noriakinakagawa/PowerPassController_LTC4417/README.md

# PowerPassController_LTC4417
LTC4417を使ったパワーパスコントローラ。安定化電源側のコネクタを抜くと瞬時にバッテリ側から電力が供給される。
バッテリ電圧が安定化電源より高くても安定化電源側を優先するので、理想ダイオードで冗長にしたものよりスマートに使える。
また、過電圧保護と低電圧保護も設定できるので、供給カットによりリチウム系バッテリの過放電を保護する。
部品は秋葉原で手に入る範囲に絞った。
