noriakinakagawa/PowerPassController_LTC4417/PJ-002B/PJ-002B.step

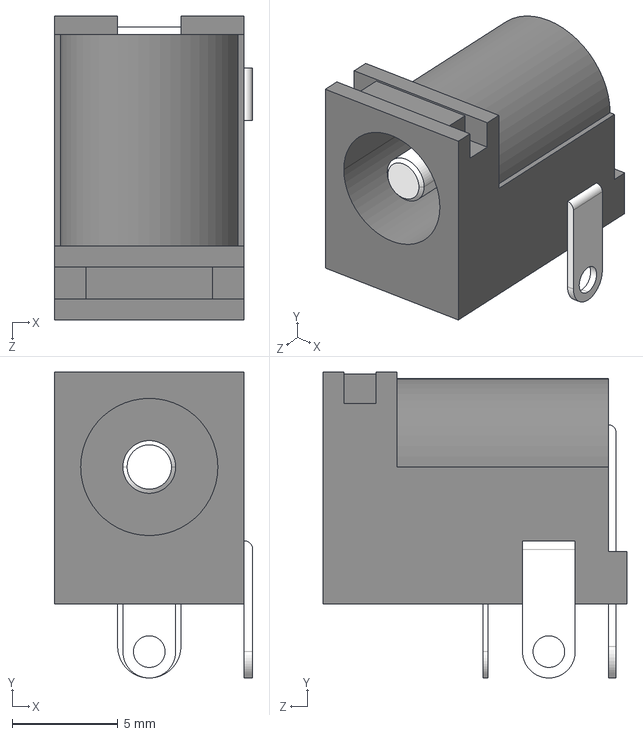
[picture p1: CAD file, 2021-08-21]
PJ-002B/PJ-002B.step
9.40 x 14.5 x 14.4 mm
