noriakinakagawa/PowerPassController_LTC4417/S3P-VH/S3P-VH.step

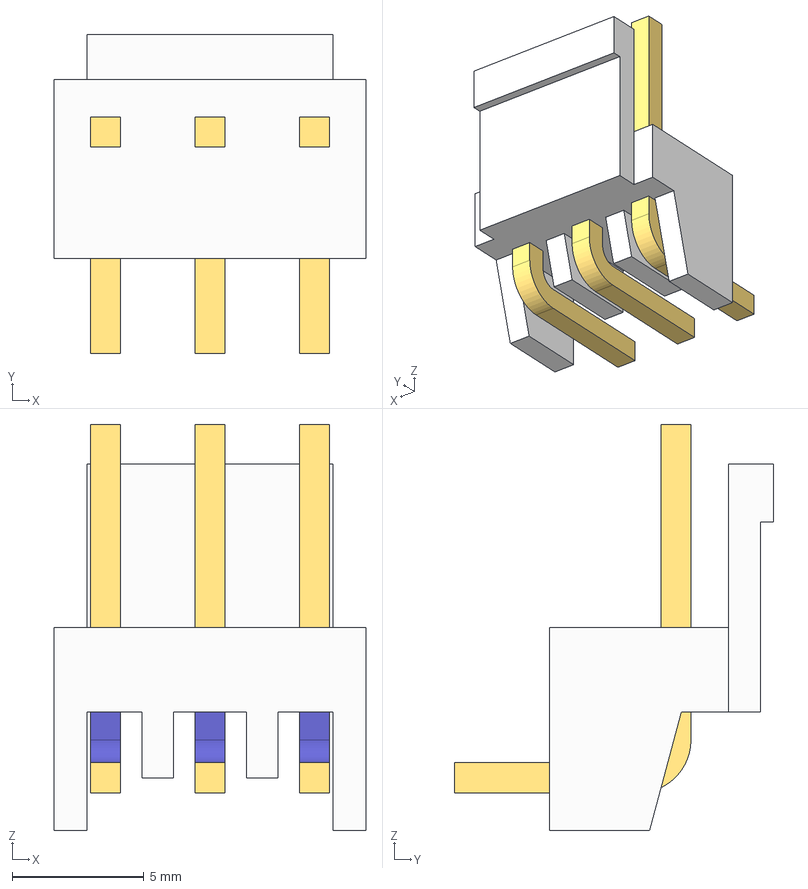
[picture p2: CAD file, 2021-08-21]
S3P-VH/S3P-VH.step
11.8 x 12.1 x 15.4 mm
