noriakinakagawa/PowerPassController_LTC4417/SMBJ45CA/SMB.step

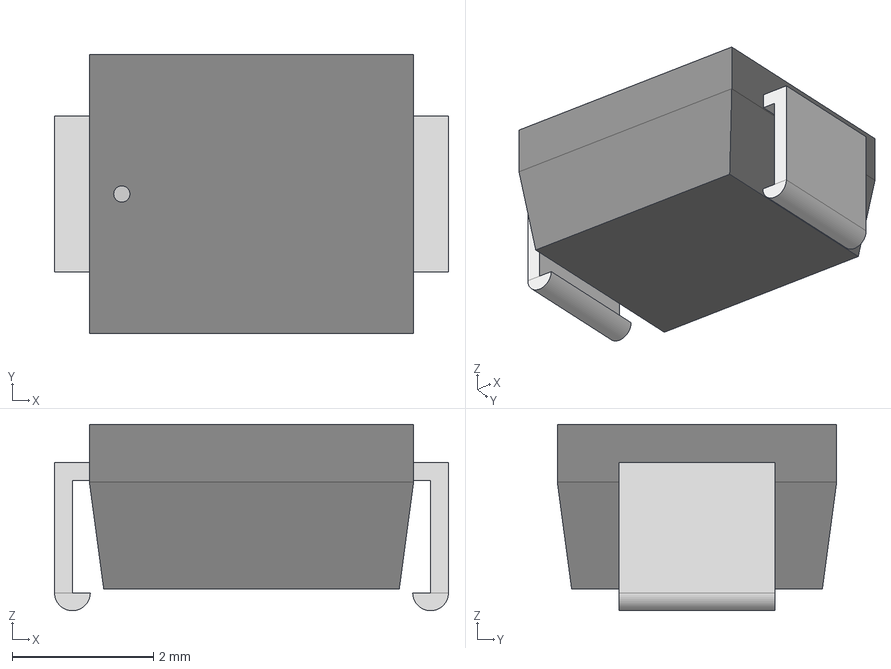
[picture p3: CAD file, 2021-08-21]
SMBJ45CA/SMB.step
5.59 x 3.96 x 2.64 mm
