noriakinakagawa/PowerPassController_LTC4417/PowerPathController_LTC4417.pdf

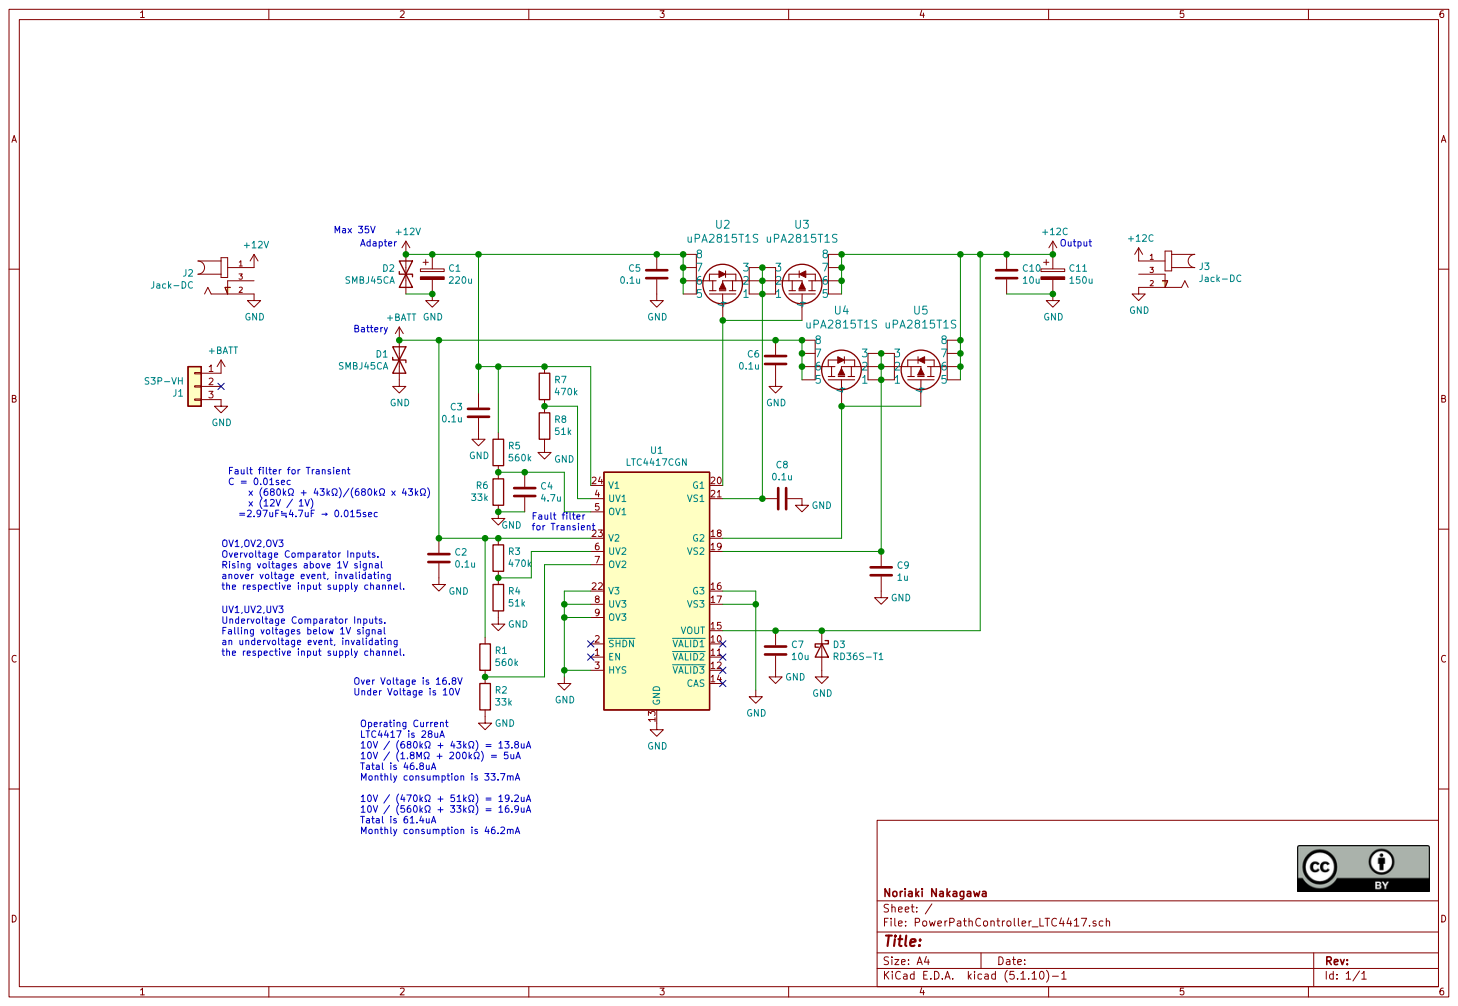
[picture p4: page 1]

Max 35V OV1,OV2,OV3 Overvoltage Comparator Inputs.

File: PowerPathController_LTC4417.sch Sheet: / Noriaki Nakagawa C8
0.1uGND

for Transient Fault filter for Transient C = 0.01sec

Rising voltages above 1V signal
anover voltage event, invalidating
the respective input supply channel. UV1,UV2,UV3 Undervoltage Comparator Inputs.

Falling voltages below 1V signal
an undervoltage event, invalidating
the respective input supply channel.
