noriakinakagawa/PowerPassController_LTC4417/PowerPathController_LTC4417.kicad_pcb

## KiCad design PowerPathController_LTC4417.kicad_pcb (2021-08-21)

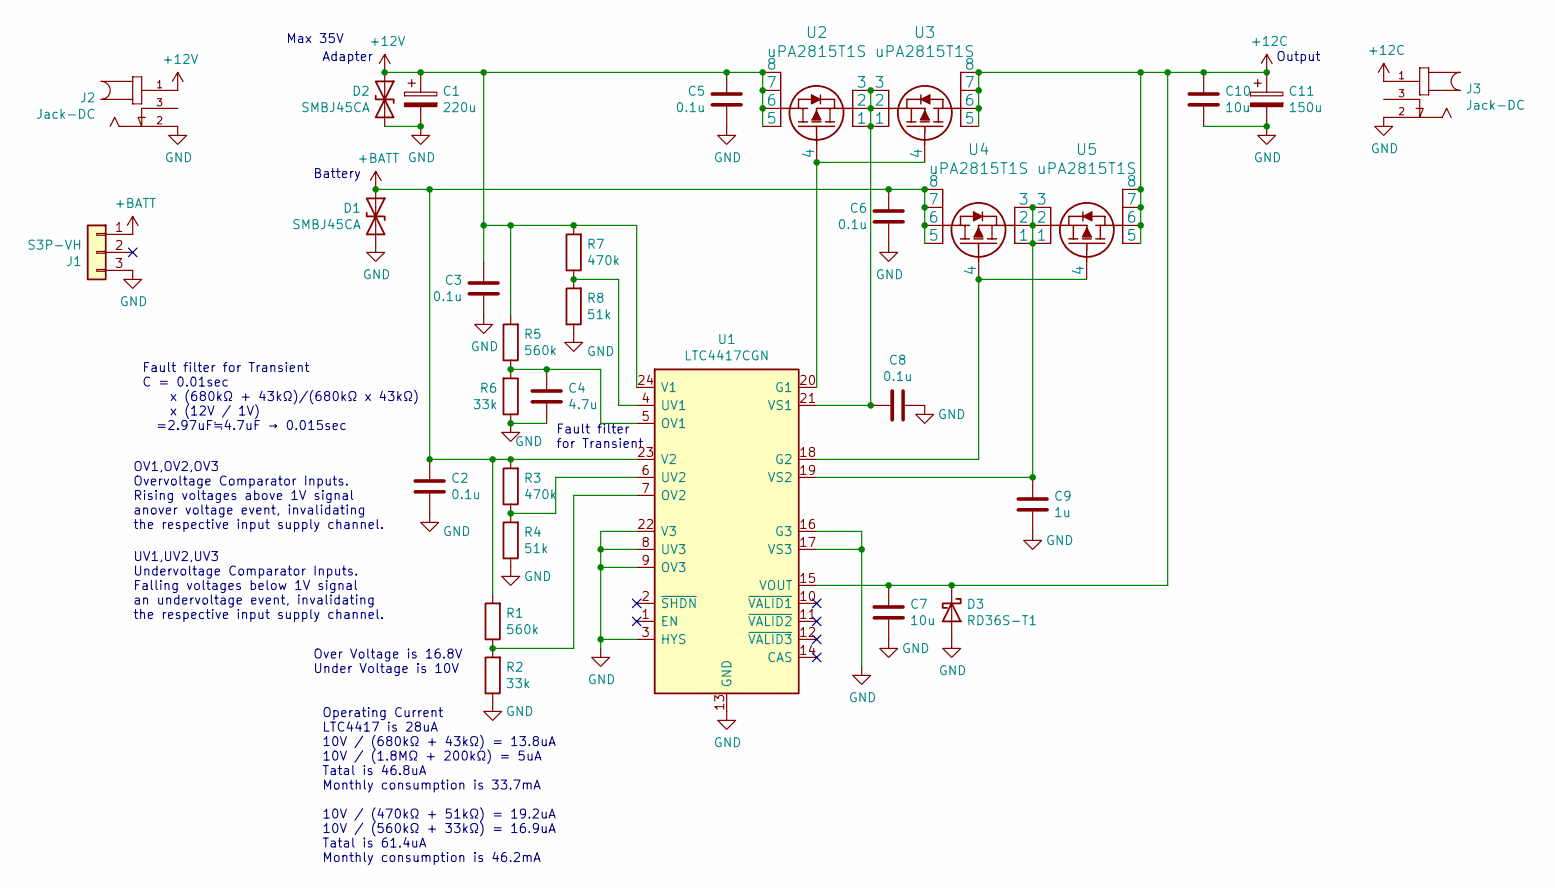
[picture p5: schematic PowerPathController_LTC4417.sch]

Parts:
C1: 220u; CP_Radial_D8.0mm_P3.50mm
C2, C3, C5, C6, C8: 0.1u; C_0603
C4: 4.7u; C_0805
C7, C10: 10u; C_1210
C9: 1u; C_0603
C11: 150u; CP_Radial_D10.0mm_P5.00mm
D1, D2: SMBJ45CA; D_SMB
D3: RD36S-T1; D_0603
J1: S3P-VH; JST_VH_S3P-VH_1x03_P3.96mm_Horizontal
J2, J3: Jack-DC; CUI_PJ-002B
R1, R5: 560k; R_Axial_DIN0207_L6.3mm_D2.5mm_P2.54mm_Vertical
R2, R6: 33k; R_Axial_DIN0207_L6.3mm_D2.5mm_P2.54mm_Vertical
R3, R7: 470k; R_Axial_DIN0207_L6.3mm_D2.5mm_P2.54mm_Vertical
R4, R8: 51k; R_Axial_DIN0207_L6.3mm_D2.5mm_P2.54mm_Vertical
U1: LTC4417CGN; SSOP-24_3.9x8.7mm_Pitch0.635mm
U2, U3, U4, U5: uPA2815T1S; UPA2815T1S-E2-AT

Connections:
+12C: C7.1, C10.1, C11.1, D3.1 (K), J3.1, U1.15 (VOUT), U3.5, U3.6, U3.7, U3.8, U5.5, U5.6, U5.7, U5.8
+12V: C1.1, C3.1, C5.1, D2.1 (A1), J2.1, R5.2, R7.2, U1.24 (V1), U2.5, U2.6, U2.7, U2.8
+BATT: C2.1, C6.1, D1.1 (A1), J1.1, R1.2, R3.2, U1.23 (V2), U4.5, U4.6, U4.7, U4.8
GND: C1.2, C2.2, C3.2, C4.2, C5.2, C6.2, C7.2, C8.2, C9.2, C10.2, C11.2, D1.2 (A2), D2.2 (A2), D3.2 (A), J1.3, J2.2, J3.2, R2.1, R4.1, R6.1, R8.1, U1.3 (HYS), U1.8 (UV3), U1.9 (OV3), U1.13 (GND), U1.16 (G3), U1.17 (VS3), U1.22 (V3)
unnamed: C4.1, R5.1, R6.2, U1.5 (OV1)
unnamed: C8.1, U1.21 (VS1), U2.1, U2.2, U2.3, U3.1, U3.2, U3.3
unnamed: C9.1, U1.19 (VS2), U4.1, U4.2, U4.3, U5.1, U5.2, U5.3
unnamed: R1.1, R2.2, U1.7 (OV2)
unnamed: R3.1, R4.2, U1.6 (UV2)
unnamed: R7.1, R8.2, U1.4 (UV1)
unnamed: U1.18 (G2), U4.4, U5.4
unnamed: U1.20 (G1), U2.4, U3.4

Notes on the sheet:
OV1,OV2,OV3 Overvoltage Comparator Inputs. Rising voltages above 1V signal anover voltage event, invalidating the respective input supply channel.
UV1,UV2,UV3 Undervoltage Comparator Inputs. Falling voltages below 1V signal an undervoltage event, invalidating the respective input supply channel.
Adapter
Battery
Output
Over Voltage is 16.8V Under Voltage is 10V
Fault filter for Transient
Fault filter for Transient C = 0.01sec x (680kΩ + 43kΩ)/(680kΩ x 43kΩ) x (12V / 1V) =2.97uF≒4.7uF → 0.015sec
Operating Current LTC4417 is 28uA 10V / (680kΩ + 43kΩ) = 13.8uA 10V / (1.8MΩ + 200kΩ) = 5uA Tatal is 46.8uA Monthly consumption is 33.7mA 10V / (470kΩ + 51kΩ) = 19.2uA 10V / (560kΩ + 33kΩ) = 16.9uA Tatal is 61.4uA Monthly consumption is 46.2mA
Max 35V

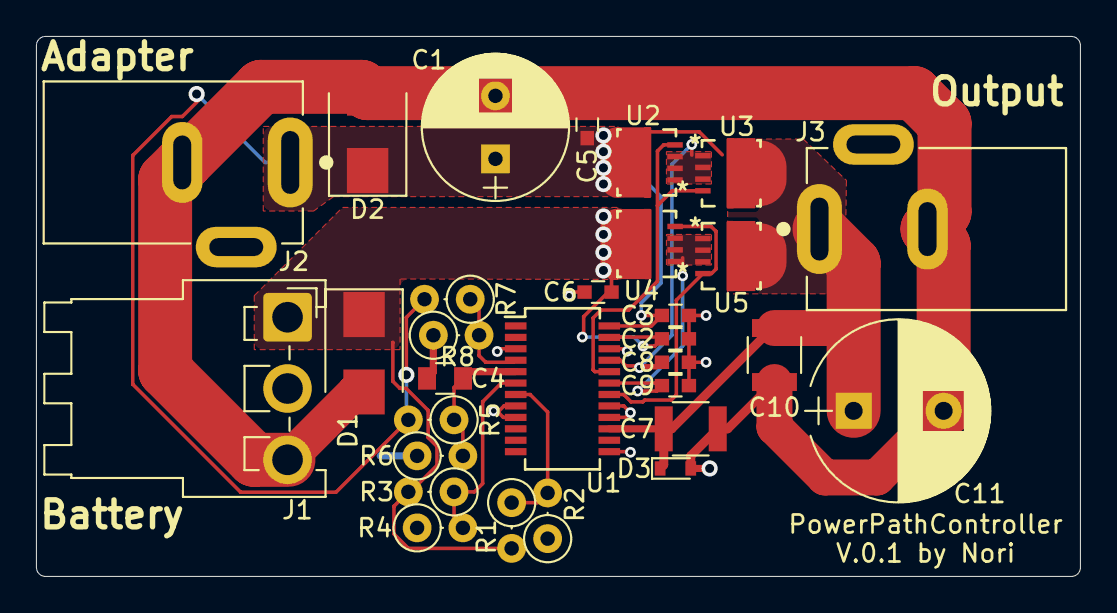
[picture p6: board PowerPathController_LTC4417.kicad_pcb from above]

Board: 2 copper layers, 58.0 x 30.0 mm, 30 parts (0 on the bottom side), 12 nets.
